Paddy625/LapTune_STM32/docs/P0_REVIEW_2026-11-02.md

# Przegląd P0 — 2 listopada 2026, firmware 2.0.1-p0

> Raport historyczny dla 2.0.1-p0. Aktualne zachowanie GPS/PPS i pamięci opisuje [GPS_PPS.md](GPS_PPS.md).

## Utrata początku: co ustalono

W wersji 4f07d42 `SDLogger_CanAccept()` zwracało true także poza nagrywaniem.
Konsument pobierał wtedy rekord z pierścienia, a `SDLogger_AppendRaw()` odrzucało
go i zwiększało sd_queue_dropped. Dotyczyło to błędów/retry SD, a także B1.
IMU było ponadto uzbrajane przed początkowym montowaniem i przygotowaniem pliku.

Zestaw `imu_ring_dropped=1`, `sd_queue_dropped=3749`, pierwszy NR=3751 jest
zgodny z tą ścieżką: jedna celowo odrzucona para startowa i 3749 rekordów
odrzuconych przez logger. Sama blokada konsumenta przez 37 s przepełniłaby
pierścień wielokrotnie i zwiększyła licznik IMU. Zatem nie jest to dowód, że
pierścień był za mały albo że urządzenie czekało na fix. Kod nie miał bramki
fix/UTC. Stare liczniki nie rozstrzygają, czy początkową przyczyną był błąd
karty, pauza B1 czy inne przejście stanu; brakuje starej historii zdarzeń.

Poprawiony start: zegar i peryferia → odbiór GPS → SD i zsynchronizowany
nagłówek → dopiero inicjalizacja/uzbrojenie IMU. Jeżeli SD nie jest gotowe,
IMU nie zaczyna właściwej akwizycji; nie ma licznika pobranych próbek do
wyzerowania. Konsument działa od pierwszej pary, niezależnie od GPS i UTC.
NR i czas nie są resetowane przy odzyskiwaniu karty ani przejściu do pliku.

Pierwsza para po uzbrojeniu pozostaje celowo odrzucana jako niepewna czasowo;
widać NR=1 i reason=1 w diagnostyce, a pierwszy prawidłowy wiersz zwykle ma
NR=2. To oddzielne zdarzenie od dawnej utraty kilkudziesięciu sekund.

Nowe znaczniki w SESSION.json, w tej samej skali mikrosekund MCU:

| Pole | Znaczenie |
| --- | --- |
| sd_ready_us | pierwsze przygotowanie pliku i udana synchronizacja nagłówka |
| imu_start_us | pierwsze udane uzbrojenie DRDY/DMA; nie resetuje się przy retry |
| first_written_us | chwila powrotu pierwszego udanego f_write z rekordami |
| first_written_sample_us | T_IMU_US pierwszego przyjętego rekordu |
| first_written_nr | oryginalny numer tego rekordu |
| last_drop_nr / last_drop_us / last_drop_reason | ostatnie rzeczywiste odrzucenie, ze wskazaniem etapu |
| sd_mount_attempts / sd_failures | historia prób i niepowodzeń w bieżącym uruchomieniu |
| sd_first_error_us/code, sd_last_error_us/code | pierwszy i ostatni błąd FatFs, bez wymazywania przy retry |

Reason: 0=brak, 1=para po uzbrojeniu, 2=pełny pierścień, 3=utracony oczekujący
DRDY, 5=jawna pauza B1, 7=niepewna paczka przy błędzie f_write. Pełna kolejka SD
lub chwilowa niedostępność karty nie są same w sobie powodem odrzucenia.

## Przepływ i pamięć

Producent IRQ/DMA jest niezależny od FatFs. Konsument najpierw podgląda rekord,
a zwalnia miejsce dopiero po przyjęciu go przez logger. Pełne 16 miejsc SD
wstrzymuje konsumenta; pozostałe próbki czekają w pierścieniu. Po błędzie SD
niepróbowane rekordy SD pozostają w RAM do wznowienia. Nie odtwarzamy starych
obiektów FIL ani sektorów/FAT na nowej karcie. Błąd częściowego zapisu powoduje
jawne odrzucenie tylko próbowanej, niepewnej paczki; importer powinien też
obsługiwać duplikaty po awarii nośnika według sesji i NR.

Pojemności podawane są w **pojedynczych rekordach**, nie w paczkach:

| Bufor | Pojemność | Rozmiar elementu na ARM | RAM |
| --- | ---: | ---: | ---: |
| Pierścień IMU | 256 slotów, 255 użytecznych | 32 B | 8192 B |
| Kolejka SD | 16 rekordów | 96 B | 1536 B |
| Tekstowa paczka zapisu | 1024 bajty | — | 1024 B |
| RX UART | 1024 sloty, 1023 użyteczne | 1 B | 1024 B |
| DMA SPI2 | TX 17 + RX 17 bajtów | — | 34 B |
| TX konfiguracji GPS | 28 bajtów | — | 28 B |

Nie zwiększono liczby slotów. Rekord SD zawiera oryginalny IMU, pomocniczy UTC
i migawkę GPS z czasem odbioru. Pierścień pokrywa około 2,45 s przy nominalnych
104 Hz; kolejka SD około 154 ms. Pauza 1,163 s wymaga około 121 miejsc
w pierścieniu, a nie w kolejce tekstowej. Aktualne i maksymalne zapełnienia są
mierzone: raw_ring_high_water, sd_queue_high_water i sd_queue_depth.

Kompilacja Debug po zmianach: **17 032 B statycznego RAM**, 3448 B na stos/heap.
Linker rezerwuje 2560 B stosu oraz minimum 512 B heap; pozostaje 376 B ponad te
rezerwacje. Heap może zająć łącznie 888 B przy zachowaniu rezerwacji stosu.
To nie jest dodatkowe 20 KB poza buforami. Dokładny raport dla każdej kompilacji
powstaje jako memory-report.json; Release może mieć inne wyrównanie sekcji.

Największe pojedyncze ramki GCC Debug to Session_Write 800 B i formatter 712 B.
To nie jest suma zagnieżdżonych wywołań ani dowód maksymalnego stosu: raporty
.su nie obejmują pełnego wnętrza newlib. Na urządzeniu stos jest znakowany przy
starcie przed HAL i mierzony konserwatywnie; SESSION zawiera stack_reserved_bytes,
stack_free_min_bytes i heap_used_bytes. Należy sprawdzić minimum podczas
rzeczywistego najgorszego zapisu/rysowania/przerwań; w chmurze nie zmierzono
sprzętowego maksimum stosu. Native testy zwracają w tych polach 0.

TX/RX DMA są statyczne i nie kończą życia z funkcją. TX GPS także jest
statyczne, pozostaje zajęte do callbacku TX complete, ma watchdog 100 ms i nie
jest nadpisywane podczas transmisji. Akwizycja nie korzysta z buforów na stosie.

## Zegar i PPS na PA0

Konfiguracja nominalna: HSI/2 × PLL16 = 64 MHz; APB1 /2 = 32 MHz; ponieważ APB
jest dzielone, TIM2 dostaje **2 × PCLK1 = 64 MHz**. PSC=63 daje nominalnie 1 MHz,
ARR=65535 przepełnia się co 65,536 ms. Dla APB /1 mnożnik jest 1, również dla
aliasowych kodów /1. Metadane zapisują wejście, PSC, tick i ARR.

Odczyt 64-bitowy blokuje przerwania na krótki odczyt, uwzględnia UIF przed ISR
i ponownie czyta CNT po zauważeniu przepełnienia. Ta sama funkcja służy IMU,
końcom ramek UART, błędom, zapisowi i migawkom. Nie przeliczamy skali przez
założenie, że IMU ma idealne 104 Hz. Wynik około 103,51 Hz może pochodzić
z zegara MCU, rzeczywistego ODR albo obu i wymaga niezależnej referencji.

**Podłączone PPS → PA0 / A0 / CN8 pin 1**, logika 3,3 V i wspólna masa.
TIM2_CH1 sprzętowo przechwytuje zbocze. ISR rozszerza CCR1 do tej samej skali
64-bitowej, rozróżniając zbocze przed/po przepełnieniu. Zapisywane są:
pps_pulses, pps_last_capture_us, ostatni/min/max/średni okres w taktach TIM2,
pps_periods, pps_capture_overruns i pps_rejected_periods. Okresy poza
0,8–1,2 s nominalnego czasu MCU nie są używane do średniej 1 Hz.

Do rzeczywistego pomiaru trzeba potwierdzić, że PPS odbiornika to ważna,
GNSS-zablokowana referencja 1 Hz. Wtedy średnia liczba taktów na impuls
pokazuje skalę zegara: przy nominalnych 1 MHz różnica od 1 000 000 taktów ma
tę samą wartość liczbową w ppm. Nie dyscyplinujemy ani nie przestawiamy licznika.
W tej sesji nie otrzymano nowych pomiarów z płytki, dlatego pozostaje
**timestamp_accuracy_validated=false** i pps_reference_validated=false.

```sh
python3 tools/check_session.py /sciezka/do/folderu/sesji
```

Narzędzie sprawdza monotoniczność, luki NR, rozkład dt, stan zapisu i diagnostykę
PPS. Nie zamienia zadanej ODR w referencję czasu.

## UART GPS i epoki

Poprzednie 13 zbiorczych błędów nie pozwala ustalić ich rodzaju ani momentu.
Ich późniejsza stała wartość jest zgodna z błędami podczas baudrate/startu,
ale nie dowodzi tego. Nowa diagnostyka rozdziela framing, noise, overrun,
parity i other oraz fazy init/reconfigure i run. Run oznacza stan konfiguracji
READY, a nie obecność fixa. Są czasy pierwszego/ostatniego błędu UART globalnie
i w każdej fazie, oddzielne checksum init/run oraz ich pierwsze/ostatnie czasy.
Kilka ustawionych bitów w jednym callbacku zwiększa odpowiednie liczniki,
lecz globalny uart_errors rośnie raz. Historii nie kasuje ponowne wykrycie GPS.

Konfiguracja używa teraz HAL_UART_Transmit_IT, bez blokującego oczekiwania
80 ms. Czekanie na odpowiedzi odbywa się stanami/deadline'ami, obok zapisu IMU.
Pole gps_configuration_state: **0=pending/configuring, 1=READY po ACK i readback,
2=ERROR**. Wartość 1 nie potwierdza fixa, UTC, PPS ani dokładności czasu.

CSV ma **36 kolumn**. Dotychczasowe 33 pozostają na początku; dochodzą
GPS_T_RX_US, GPS_T_MEAS_US i TIME_SYNC_STATE. Przy I współrzędne, prędkość
i wysokość nadal są puste, ale znane ID/iTOW/RX pozostają liczbami, także
z ostatniej znanej epoki podczas timeoutu. I ma pierwszeństwo; obecność ID
nie czyni pozycji ważną. Przed odebraniem jakiejkolwiek epoki pola są puste.

- gps_received_epochs: jedna nowa zidentyfikowana epoka NAV według iTOW, od pierwszego poprawnego checksum fragmentu.
- gps_published_epochs: epoki opublikowane po skompletowaniu/deadline; starsze od już opublikowanej mogą zostać odrzucone.
- gps_valid_epochs: opublikowane epoki z poprawną pozycją.
- GPS_INVALID_FIXES / gps_invalid_fixes: nowe opublikowane nieważne epoki; nie kolejne pętle, timeouty ani powtarzane wiersze I.

POSLLH, VELNED i SOL nadal są łączone tylko po identycznym iTOW. Cache R jest
niezmienne. Identyczna nowa pozycja otrzymuje N i nowy ID. Późna wysokość lub
prędkość nie poprawia już opublikowanej epoki. ID jest monotoniczne w sesji,
a iTOW jest oryginalnym czasem tygodnia i może prawidłowo wynosić 0.

## Migawki i synchronizacja zapisu

snapshot_t_us określa chwilę przejęcia kopii liczników, a nie zakończenia
zapisu JSON. Kopie IMU/UART są przejmowane atomowo względem ISR; FatFs może
potem obsługiwać nowe ramki bez zmiany tej migawki. SESSION.bak jest poprzednią
migawką tego samego boot_id. Aktualizacja: start, zmiana konfiguracji,
co około 5 s, rotacja i kontrolowane B1. Wiersze są synchronizowane przed
okresową migawką; zamknięcie pliku potwierdza punkt końca przy rotacji/B1.

sd_written to liczba rekordów przyjętych przez **f_write**. sd_synced_records
liczy rekordy objęte udanym **f_sync/f_close**. Są też last_acquired_nr,
last_written_nr, last_synced_nr, last_synced_sample_us i last_synced_us.
Synchronizacja nowego, pustego nagłówka nie potwierdza rekordów starego pliku.
last_synced_nr nie oznacza, że każda niższa NR przeżyła awarie nośnika;
sd_synced_records i luki pozwalają odróżnić te sytuacje.
clean_shutdown=true oznacza kontrolowane zamknięcie loggera, nie wyłączenie
MCU ani zatrzymanie samego czujnika. Otwarcie/retry ustawia false.

Nagły zanik zasilania nie wykona końcowego JSON. Metadane mogą być o około
5 s starsze od TXT, a awaria FAT może poszerzyć różnicę; rotacja nie jest
transakcją. Backup nie daje gwarancji zachowania wszystkich danych bez
podtrzymania zasilania. Nie ogłaszamy f_write jako potwierdzenia trwałości flash.

SHA jest generowane automatycznie zarówno przez tools/build_firmware.py,
jak i prebuild CubeIDE Debug/Release. Wymagane są Git i Python w PATH.
firmware_commit ma 40 znaków SHA, firmware_dirty osobno sygnalizuje zmiany.
Brak Git/SHA zatrzymuje build zamiast wpisywać unspecified. W CubeIDE należy
wykonać Clean/Build po odświeżeniu .cproject.

## P1: granica wykonanej pracy

GPS_T_RX_US jest rzeczywistym czasem ostatniego potrzebnego odebranego
fragmentu UBX. Deadline nie jest podstawiany jako RX. GPS_T_MEAS_US pozostaje
puste, TIME_SYNC_STATE=0. Samo przechwytywanie PPS nie rozstrzyga, do którego
impulsu/tygodnia/iTOW należy konkretne rozwiązanie. Nie zgadujemy tego
z najbliższej wiadomości UART.

Następny krok to potwierdzenie zachowania TIMEPULSE/TIM-TP na firmware
z MON-VER, powiązanie właściwego impulsu z czasem GPS i estymacja mapowania
zegarów oraz błędu. Potem można przypisywać GPS do historycznych prawdziwych
wierszy albo wprowadzić opóźnione korekty w Windows. Obecny ESKF nie zacznie
tego robić po dodaniu samych kolumn. Nie deklarujemy GPS–IMU ≤5 ms.

## Weryfikacja

15 programów C z ASan/UBSan i niezależny konsument CSV/JSON przechodzą.
Test całego toru używa rzeczywistego kodu ISR/DMA, konsumenta i FatFs: brak
SD przez 37 s przed uzbrojeniem, brak GPS/UTC, pełna kolejka 16, pauza
1,163415 s z 121 zdarzeniami i brak strat poza oznaczoną parą startową.
Następnie wymuszony nadmiar daje pełny pierścień, luki NR i reason=2.
To test symulowany, nie pomiar zachowania konkretnej karty.

Pozostałe regresje: dwie godziny zegara i przepełnienia/wyścig odczytu,
capture przed/po overflow, syntetyczne PPS ze skalą +4700 ppm, 13 startowych
błędów UART zachowanych po rekonfiguracji, runtime FE/NE/ORE, deadline i
ważność epok, 30 minut czasu symulowanego FatFs, TXT2 i okresowe/końcowe
migawki z punktami sync oraz clean_shutdown. Testy nie mierzą fizycznego
p99 timestampu, dryfu HSI, skali PPS ani maksimum stosu na Nucleo.
