Paddy625/LapTune_STM32/docs/wiring_sd.png

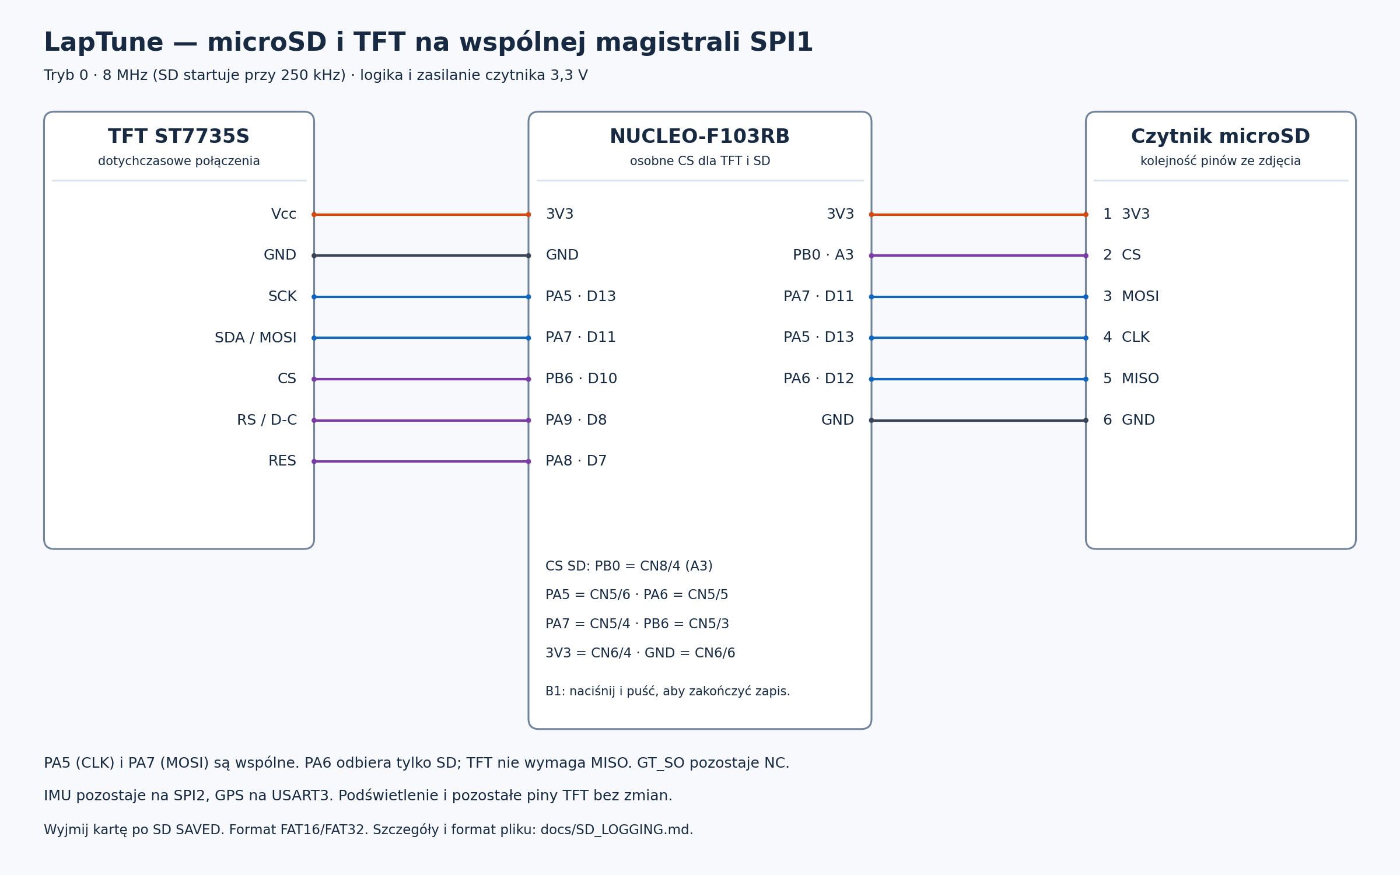
docs/wiring_sd.png
