Paddy625/LapTune_STM32/LapTune/Core/Src/main.c

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
/* Includes ------------------------------------------------------------------*/
#include "main.h"

/* USER CODE BEGIN Includes */

#include "acc.h"
#include "boot_identity.h"
#include "timebase.h"
#include "memory_diag.h"
#include "imu_stream.h"
#include "acc_display.h"
#include "gps.h"
#include "gps_display.h"
#include "sd_spi.h"
#include "sd_logger.h"
#include <stdio.h>
#include <string.h>

/* USER CODE END Includes */

SPI_HandleTypeDef hspi1;
SPI_HandleTypeDef hspi2;

UART_HandleTypeDef huart2;
UART_HandleTypeDef huart3;

/* USER CODE BEGIN PV */

float ax, max_x=0, min_x=0, ay, max_y=0, min_y=0, az, max_z=0, min_z=0;
float gx, min_gx=0, max_gx=0, gy, min_gy=0, max_gy=0, gz, min_gz=0, max_gz=0;
static uint8_t sensor_ok, have_sample, sample_valid;
static uint32_t last_sensor_retry;
static uint8_t app_ready,tft_ready;
static uint32_t last_ui_slice;
static uint32_t last_ui_nr;

/* USER CODE END PV */

void SystemClock_Config(void);
static void MX_GPIO_Init(void);
static void MX_USART2_UART_Init(void);
static void MX_USART3_UART_Init(void);
static void MX_SPI1_Init(void);
static void MX_SPI2_Init(void);
/* USER CODE BEGIN PFP */
void Logger_OnImuRecord(const ImuRecord *record);

/* USER CODE END PFP */

/* USER CODE BEGIN 0 */
void Logger_ServiceIO(void)
{
  if (!app_ready) return;
  GPS_Process((uint32_t)(Timebase_NowUs()/1000U));
  ImuStream_Service();
}
static void ServiceAcquisition(void)
{
  if (!app_ready) return;
  GPS_Process((uint32_t)(Timebase_NowUs()/1000U));
  ImuStream_Service();
  ImuRecord latest;
  if (ImuStream_Latest(&latest) && latest.nr!=last_ui_nr) Logger_OnImuRecord(&latest);
  SDLogger_ConsumeImu();
}
void Logger_OnImuRecord(const ImuRecord *record)
{
    if (record->flags) {
      if (record->nr>=last_ui_nr) { last_ui_nr=record->nr; sample_valid=0; }
      return;
    }
    LSM6DS3_Sample sample;
    ImuStream_Scale(record,&sample);
    /* Old buffered samples update extrema without moving the live values backwards. */
    if (!have_sample) {
      min_x=max_x=sample.ax; min_y=max_y=sample.ay; min_z=max_z=sample.az;
      min_gx=max_gx=sample.gx; min_gy=max_gy=sample.gy; min_gz=max_gz=sample.gz;
      have_sample=1;
    }
    if (sample.ax>max_x) max_x=sample.ax;
    if (sample.ax<min_x) min_x=sample.ax;
    if (sample.ay>max_y) max_y=sample.ay;
    if (sample.ay<min_y) min_y=sample.ay;
    if (sample.az>max_z) max_z=sample.az;
    if (sample.az<min_z) min_z=sample.az;
    if (sample.gx>max_gx) max_gx=sample.gx;
    if (sample.gx<min_gx) min_gx=sample.gx;
    if (sample.gy>max_gy) max_gy=sample.gy;
    if (sample.gy<min_gy) min_gy=sample.gy;
    if (sample.gz>max_gz) max_gz=sample.gz;
    if (sample.gz<min_gz) min_gz=sample.gz;
    if (record->nr>=last_ui_nr) {
      last_ui_nr=record->nr; sample_valid=1;
      ax=sample.ax; ay=sample.ay; az=sample.az;
      gx=sample.gx; gy=sample.gy; gz=sample.gz;
    }

}

/* Storage may call this while a FatFs write is in progress. IMU acquisition
   continues in EXTI/DMA; only drain GPS here, never re-enter the SD queue. */
void SD_SPI_Service(void)
{
  if (!app_ready) return;
  GPS_Process((uint32_t)(Timebase_NowUs()/1000U));
}

static HAL_StatusTypeDef ShowLogState(void)
{
  static char previous[26];
  char text[26];
  SDLogger_StatusText(text);
  if (!strcmp(previous,text)) return HAL_OK;
  HAL_StatusTypeDef result=TFT_Text(4,120,text,1,sd_log_state==LOG_RECORDING || sd_log_state==LOG_STOPPED ? TFT_WHITE : TFT_RED,TFT_BLACK);
  if (result==HAL_OK) (void)strcpy(previous,text);
  return result;
}


/* USER CODE END 0 */

/**
  * @brief  The application entry point.
  * @retval int
  */
int main(void)
{

  /* USER CODE BEGIN 1 */
  MemoryDiag_Init();

  /* USER CODE END 1 */

  /* MCU Configuration--------------------------------------------------------*/

  /* Reset of all peripherals, Initializes the Flash interface and the Systick. */
  HAL_Init();

  /* Configure the system clock */
  SystemClock_Config();

  /* USER CODE BEGIN SysInit */
  /* Flash journal is updated before the acquisition clock/interrupts start. */
  if (!BootIdentity_Init()) Error_Handler();
  Timebase_Init();

  /* USER CODE END SysInit */

  /* Initialize all configured peripherals */
  MX_GPIO_Init();
  MX_USART2_UART_Init();
  MX_SPI2_Init();
  MX_SPI1_Init();
  MX_USART3_UART_Init();
  /* USER CODE BEGIN 2 */

  tft_ready=TFT_Init(&hspi1)==HAL_OK && AccDisplay_Init()==HAL_OK;
  if (GPS_Init(&huart3) != HAL_OK) Error_Handler();
  /* GPS configures 5 Hz and PPS asynchronously, independent of fix and SD. */
  app_ready=1; /* GPS RX/configuration can be serviced during initial SD setup. */
  SD_SPI_Bind(&hspi1);
  SDLogger_Start(); /* Prepare and sync the file before arming acquisition. */
  last_sensor_retry=HAL_GetTick()-1000U;

  /* USER CODE END 2 */

  /* Infinite loop */
  /* USER CODE BEGIN WHILE */
  while (1)
  {
    /* USER CODE END WHILE */

    /* USER CODE BEGIN 3 */
    ServiceAcquisition();
    uint32_t now=HAL_GetTick();
    if (sensor_ok && (uint32_t)(now-last_sensor_retry)>=1000U &&
        ImuStream_Stalled(1000000U)) {
      ImuStream_Stop(); sensor_ok=0;
    }
    if (!sensor_ok && (uint32_t)(now-last_sensor_retry)>=1000U) {
      ImuStream_Stop();
      sensor_ok=Logger_StartAcquisition();
      last_sensor_retry=HAL_GetTick();
    }
    Logger_ServiceStorage();
    if (!tft_ready || SDLogger_Backlogged() || (uint32_t)(HAL_GetTick()-last_ui_slice)<100U) {
      HAL_Delay(1U);
      continue;
    }
    last_ui_slice=HAL_GetTick();
    const IMU_DisplayData readings = {
      .accel = {ax, ay, az},
      .accel_min = {min_x, min_y, min_z},
      .accel_max = {max_x, max_y, max_z},
      .gyro = {gx, gy, gz},
      .gyro_min = {min_gx, min_gy, min_gz},
      .gyro_max = {max_gx, max_gy, max_gz}
    };
    if (AccDisplay_Update(HAL_GetTick(), &readings,
                          sensor_ok && have_sample && sample_valid) != HAL_OK) {
      tft_ready=0;
    }
    if (tft_ready && GPSDisplay_Update(HAL_GetTick(), GPS_GetData(), GPS_GetConfig()) != HAL_OK) {
      tft_ready=0;
    }
    if (tft_ready && ShowLogState()!=HAL_OK) tft_ready=0;
    HAL_Delay(1U);
  }
  /* USER CODE END 3 */
}

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
/* USER CODE BEGIN 4 */
void HAL_GPIO_EXTI_Callback(uint16_t pin)
{
  /* Debounced B1 release requests foreground stop/resume; no FatFs in IRQ. */
  if (pin==GPIO_PIN_1) ImuStream_OnDrdy(0);
  else if (pin==GPIO_PIN_4) ImuStream_OnDrdy(1);
  else if (pin==B1_Pin) SDLogger_Button();
}

void HAL_SPI_TxRxCpltCallback(SPI_HandleTypeDef *spi)
{ if (spi==&hspi2) ImuStream_OnComplete(); }
void HAL_SPI_ErrorCallback(SPI_HandleTypeDef *spi)
{ if (spi==&hspi2) ImuStream_OnError(); }

void HAL_UART_RxCpltCallback(UART_HandleTypeDef *uart)
{
  GPS_OnRxComplete(uart);
}

void HAL_UART_TxCpltCallback(UART_HandleTypeDef *uart)
{ GPS_OnTxComplete(uart); }

void HAL_UART_ErrorCallback(UART_HandleTypeDef *uart)
{
  GPS_OnError(uart);
}


/* USER CODE END 4 */
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
