Paddy625/LapTune_STM32/LapTune/Core/Inc/main.h

#define B1_Pin GPIO_PIN_13
#define B1_GPIO_Port GPIOC
#define B1_EXTI_IRQn EXTI15_10_IRQn
#define USART_TX_Pin GPIO_PIN_2
#define USART_TX_GPIO_Port GPIOA
#define USART_RX_Pin GPIO_PIN_3
#define USART_RX_GPIO_Port GPIOA
#define TFT_CS_Pin GPIO_PIN_6
#define TFT_CS_GPIO_Port GPIOB
#define TFT_DC_Pin GPIO_PIN_9
#define TFT_DC_GPIO_Port GPIOA
#define TFT_RST_Pin GPIO_PIN_8
#define TFT_RST_GPIO_Port GPIOA
#define TMS_Pin GPIO_PIN_13
#define TMS_GPIO_Port GPIOA
#define TCK_Pin GPIO_PIN_14
#define TCK_GPIO_Port GPIOA
#define SWO_Pin GPIO_PIN_3
#define SWO_GPIO_Port GPIOB
#define SD_CS_Pin GPIO_PIN_0
#define SD_CS_GPIO_Port GPIOB
