Paddy625/LapTune_STM32/LapTune/Core/Src/gps_epoch.c

#include "gps_epoch.h"
#include "gps_time.h"
#include <string.h>
#define WEEK_MS 604800000UL
#define HISTORY 16U
_Static_assert(sizeof(GPS_Fix)==48,"GPS snapshot RAM budget");
typedef struct {
    uint64_t first_us,last_us;
    GPS_Fix fix;
    int16_t week;
    uint8_t seen,parts,fix_type,flags,satellites;
} Slot;
static Slot slots[4];
static GPS_Fix history[HISTORY];
static unsigned history_head,history_count;
static uint32_t sequence,last_itow;
static uint64_t last_valid_rx,stream_start_us;
static int16_t last_week;
static uint8_t have_itow;
GPS_Diagnostics gps_diag;
static uint8_t nmea_mode,nmea_parts,nmea_valid,have_nmea_key;
static uint32_t nmea_key,last_nmea_key;
static uint64_t nmea_first,last_nmea_rx;
static GPS_Fix nmea_pending;
static void nmea_publish(uint64_t now)
{
    if (!nmea_parts) return;
    nmea_pending.position_valid=nmea_valid==nmea_parts;
    nmea_pending.altitude_valid&=nmea_pending.position_valid;
    nmea_pending.speed_valid&=nmea_pending.position_valid;
    nmea_pending.published_us=now;
    nmea_pending.fix_id=++sequence; nmea_pending.epoch_known=1; nmea_pending.nmea=1;
    nmea_pending.meas_delay_us=UINT32_MAX;
    ++gps_diag.received_epochs; ++gps_diag.epoch_count;
    if (nmea_pending.position_valid) ++gps_diag.valid_epochs; else ++gps_diag.invalid_fixes;
    if (have_nmea_key) {
        uint32_t dt=(nmea_key+86400000U-last_nmea_key)%86400000U;
        if (dt && dt<=3000) {
            if (!gps_diag.min_period_ms || dt<gps_diag.min_period_ms) gps_diag.min_period_ms=dt;
            if (dt>gps_diag.max_period_ms) gps_diag.max_period_ms=dt;
            if (dt!=1000) ++gps_diag.bad_period;
        }
    }
    last_nmea_key=nmea_key; last_nmea_rx=nmea_pending.rx_us; have_nmea_key=1;
    history[history_head]=nmea_pending; history_head=(history_head+1U)%HISTORY;
    if (history_count<HISTORY) ++history_count;
    nmea_parts=nmea_valid=0;
}
static uint8_t nmea_time(const char *line,uint32_t *key)
{
    const char *p=strchr(line,','); if (!p || strlen(++p)<6) return 0;
    unsigned h=0,m=0,sec=0,ms=0;
    for (unsigned i=0;i<6;++i) if (p[i]<'0' || p[i]>'9') return 0;
    h=(p[0]-'0')*10U+p[1]-'0'; m=(p[2]-'0')*10U+p[3]-'0'; sec=(p[4]-'0')*10U+p[5]-'0';
    if (h>23 || m>59 || sec>59) return 0;
    p+=6;
    if (*p=='.') {
        unsigned scale=100; ++p;
        if (*p<'0' || *p>'9') return 0;
        while (*p>='0' && *p<='9') { ms+=(*p++-'0')*scale; scale/=10; }
    }
    if (*p!=',') return 0;
    *key=((h*60U+m)*60U+sec)*1000U+ms; return 1;
}
static uint32_t u32(const uint8_t *p) { return (uint32_t)p[0]|((uint32_t)p[1]<<8)|((uint32_t)p[2]<<16)|((uint32_t)p[3]<<24); }
static int32_t i32(const uint8_t *p) { uint32_t n=u32(p); return n<=INT32_MAX ? (int32_t)n : (int32_t)((int64_t)n-4294967296LL); }
static void remember(GPS_Fix fix)
{
    history[history_head]=fix; history_head=(history_head+1U)%HISTORY;
    if (history_count<HISTORY) ++history_count;
}
static void invalidate(GPS_Data *d,uint64_t now)
{
    if (d->position_valid || !history_count || history[(history_head+HISTORY-1)%HISTORY].position_valid)
    {
        GPS_Fix f=history_count ? history[(history_head+HISTORY-1)%HISTORY] : (GPS_Fix){0};
        f.published_us=now; f.position_valid=f.speed_valid=f.altitude_valid=0;
        f.time_sync_state=f.discarded_incomplete=0; f.meas_delay_us=UINT32_MAX;
        remember(f);
    }
    d->position_valid=d->speed_valid=d->altitude_valid=0;
}
void GPS_Epoch_Init(void)
{
    nmea_mode=nmea_parts=nmea_valid=have_nmea_key=0;
    memset(slots,0,sizeof(slots)); memset(history,0,sizeof(history)); memset(&gps_diag,0,sizeof(gps_diag));
    history_head=history_count=sequence=last_itow=have_itow=0; last_valid_rx=stream_start_us=0; last_week=0;
    GPS_Time_Init();
}
void GPS_Epoch_InitNMEA(void) { GPS_Epoch_Init(); nmea_mode=1; }
void GPS_Epoch_NMEA(const GPS_Data *d,const char *line,uint64_t rx)
{
    uint32_t key;
    if (!nmea_time(line,&key)) {
        nmea_parts=nmea_valid=0;
        GPS_Fix invalid={.published_us=rx,.rx_us=rx,.meas_delay_us=UINT32_MAX,.nmea=1};
        remember(invalid); return;
    }
    uint8_t part=line[3]=='G' ? 1 : 2;
    if (have_nmea_key && key==last_nmea_key && rx>=last_nmea_rx && rx-last_nmea_rx<3000000U) return;
    if (nmea_parts && key!=nmea_key) nmea_publish(rx);
    if (!nmea_parts) {
        nmea_pending=(GPS_Fix){0}; nmea_first=rx; nmea_key=key; nmea_valid=0;
    }
    if (nmea_parts&part) return;
    nmea_parts|=part; nmea_pending.rx_us=rx;
    if (d->position_valid) {
        nmea_valid|=part;
        /* Prefer RMC coordinates when both members of this UTC epoch exist. */
        if (part==2 || !(nmea_parts&2)) {
            nmea_pending.latitude_e7=d->latitude_e7; nmea_pending.longitude_e7=d->longitude_e7;
        }
    }
    if (part==1) { nmea_pending.altitude_valid=d->altitude_valid; nmea_pending.altitude_mm=d->altitude_mm; }
    else { nmea_pending.speed_valid=d->speed_valid; nmea_pending.speed_millikmh=d->speed_millikmh; }
    if (nmea_parts==3) nmea_publish(rx);
}
void GPS_Epoch_ResetStream(GPS_Data *d,uint64_t now)
{
    nmea_parts=nmea_valid=have_nmea_key=0;
    invalidate(d,now); memset(slots,0,sizeof(slots)); have_itow=0; stream_start_us=now;
    d->connected=d->datetime_valid=d->receiver_fix_valid=0;
    GPS_Time_Reset();
}
static void publish(GPS_Data *d,Slot *s,uint64_t now)
{
    GPS_Fix *f=&s->fix;
    f->published_us=now; f->rx_us=s->last_us; f->epoch_known=1;
    f->time_valid=(s->parts&4U) && (s->flags&0x0CU)==0x0CU && s->week>=0;
    f->position_valid=(s->parts&5U)==5U && f->time_valid && (s->flags&1U) && (s->fix_type==2 || s->fix_type==3);
    f->speed_valid=f->position_valid && (s->parts&2U);
    f->altitude_valid=f->position_valid && s->fix_type==3;
    f->meas_delay_us=UINT32_MAX; f->time_sync_state=0;
    if (f->position_valid) {
        /* An unqualified pre-fix TOW must never become the ordering anchor.
           After a real fix outage, accept the receiver's corrected time afresh. */
        if (have_itow) {
            int64_t dt=(int64_t)(s->week-last_week)*WEEK_MS+(int64_t)f->itow_ms-last_itow;
            if (dt<=0 && f->rx_us>=last_valid_rx && f->rx_us-last_valid_rx<GPS_EPOCH_TIMEOUT_US) {
                ++gps_diag.late; s->seen=s->parts=0; return;
            }
            if (dt>0 && dt<=1000) {
                if (!gps_diag.min_period_ms || (uint32_t)dt<gps_diag.min_period_ms) gps_diag.min_period_ms=(uint32_t)dt;
                if ((uint32_t)dt>gps_diag.max_period_ms) gps_diag.max_period_ms=(uint32_t)dt;
                if (dt!=200) ++gps_diag.bad_period;
            }
        }
        last_itow=f->itow_ms; last_week=s->week; last_valid_rx=f->rx_us; have_itow=1;
    }
    if (f->time_valid) {
        GPS_Time_Navigation((uint16_t)s->week,f->itow_ms,f->rx_us);
        uint64_t measurement;
        if (GPS_Time_Map((uint16_t)s->week,f->itow_ms,f->rx_us,&measurement)) {
            f->meas_delay_us=(uint32_t)(f->rx_us-measurement); f->time_sync_state=1;
        }
    }
    ++gps_diag.epoch_count;
    if (!f->position_valid) ++gps_diag.invalid_fixes; else ++gps_diag.valid_epochs;
    /* A missing status fragment is not evidence that the receiver lost its fix.
       Keep the last complete solution only until its explicit 800 ms expiry. */
    uint8_t incomplete_status=(s->parts&5U)!=5U;
    if (!f->position_valid && incomplete_status && d->position_valid &&
        now>=last_valid_rx && now-last_valid_rx<GPS_EPOCH_TIMEOUT_US) {
        /* Keep a tombstone for duplicate rejection without replacing the live cache. */
        f->discarded_incomplete=1; remember(*f);
        s->seen=s->parts=0; return;
    }
    remember(*f);
    d->position_valid=f->position_valid; d->speed_valid=f->speed_valid; d->altitude_valid=f->altitude_valid;
    d->latitude_e7=f->latitude_e7; d->longitude_e7=f->longitude_e7;
    d->altitude_mm=f->altitude_mm; d->speed_millikmh=f->speed_millikmh;
    d->position_ms=d->speed_ms=d->altitude_ms=(uint32_t)(now/1000U);
    d->fix_quality=d->position_valid ? ((s->flags&2U)?2:1) : 0;
    s->seen=s->parts=0;
}
static uint8_t days(uint16_t y,uint8_t m)
{
    static const uint8_t table[]={31,28,31,30,31,30,31,31,30,31,30,31};
    return table[m-1]+(m==2 && y%4==0 && (y%100!=0 || y%400==0));
}
static void utc_rejected(const uint8_t *p,unsigned len,uint64_t now,uint8_t reason)
{
    GPS_UTCDiagnostics *u=&gps_diag.utc;
    u->last_rejected_us=now; u->last_rejected_reason=reason;
    u->last_rejected_length=(uint16_t)len;
    memset(u->last_rejected_payload,0,sizeof(u->last_rejected_payload));
    unsigned stored=len<sizeof(u->last_rejected_payload) ? len : sizeof(u->last_rejected_payload);
    if (stored) memcpy(u->last_rejected_payload,p,stored);
}
static void utc(GPS_Data *d,const uint8_t *p,unsigned len,uint64_t now)
{
    GPS_UTCDiagnostics *u=&gps_diag.utc;
    if (!u->packets) u->first_rx_us=now;
    ++u->packets; u->last_rx_us=now;
    if (len!=20) {
        ++u->rejected_length; utc_rejected(p,len,now,GPS_UTC_REJECT_LENGTH);
        return; /* Preserve the existing behavior: malformed lengths do not update UTC. */
    }
    ++u->flags_histogram[p[19]&7U];
    gps_diag.receiver.utc_flags=p[19]; gps_diag.receiver.seen|=GPS_RX_UTC;
    uint16_t year=(uint16_t)p[12]|((uint16_t)p[13]<<8);
    if ((p[19]&7)!=7) {
        ++u->rejected_flags; utc_rejected(p,len,now,GPS_UTC_REJECT_FLAGS);
        d->datetime_valid=0; return;
    }
    if (year<1980 || year>2099 || !p[14] || p[14]>12 || !p[15] ||
        p[15]>days(year,p[14]) || p[16]>23 || p[17]>59 || p[18]>59) {
        ++u->rejected_calendar; utc_rejected(p,len,now,GPS_UTC_REJECT_CALENDAR);
        d->datetime_valid=0; return;
    }
    int32_t nano=i32(p+8); if (nano<=-1000000000 || nano>=1000000000) {
        ++u->rejected_nano; utc_rejected(p,len,now,GPS_UTC_REJECT_NANO);
        d->datetime_valid=0; return;
    }
    if (!u->accepted) u->first_valid_us=now;
    ++u->accepted;
    int32_t ms=nano<0 ? -(int32_t)((-(int64_t)nano+999999)/1000000) : nano/1000000;
    int32_t day_ms=((int32_t)p[16]*3600+p[17]*60+p[18])*1000+ms;
    d->year=year; d->month=p[14]; d->day=p[15];
    if (day_ms<0) { day_ms+=86400000; if (--d->day==0) { if (--d->month==0) { d->month=12; --d->year; } d->day=days(d->year,d->month); } }
    if (day_ms>=86400000) { day_ms-=86400000; if (++d->day>days(d->year,d->month)) { d->day=1; if (++d->month>12) { d->month=1; ++d->year; } } }
    d->hour=day_ms/3600000; d->minute=(day_ms/60000)%60; d->second=(day_ms/1000)%60; d->millisecond=day_ms%1000;
    d->datetime_ms=(uint32_t)(now/1000U); d->datetime_valid=1;
    GPS_Time_Utc(u32(p),d,now);
}
void GPS_Epoch_Packet(GPS_Data *d,uint8_t cls,uint8_t id,const uint8_t *p,unsigned len,uint64_t now)
{
    if (cls!=1) return;
    if (id==0x21) {
        utc(d,p,len,now);
        if (len==20) { d->sentence_ms=(uint32_t)(now/1000U); d->connected=1; }
        return;
    }
    uint8_t part=(id==2 && len==28)?1:((id==0x12 && len==36)?2:((id==6 && len==52)?4:0));
    if (!part) return;
    if (part==4) {
        GPS_ReceiverStatus *r=&gps_diag.receiver;
        uint16_t week=(uint16_t)p[8]|((uint16_t)p[9]<<8);
        r->week=week<=INT16_MAX ? (int16_t)week : (int16_t)((int32_t)week-65536);
        r->fix_type=p[10]; r->sol_flags=p[11]; r->used_sats=p[47]; r->seen|=GPS_RX_SOL;
    }
    d->connected=1; d->sentence_ms=(uint32_t)(now/1000U);
    uint32_t itow=u32(p); if (itow>=WEEK_MS) return;
    Slot *s=NULL,*empty=NULL,*oldest=&slots[0];
    for (unsigned i=0;i<4;++i) {
        if (slots[i].seen && slots[i].fix.itow_ms==itow) s=&slots[i];
        if (!slots[i].seen) empty=&slots[i];
        if (slots[i].first_us<oldest->first_us) oldest=&slots[i];
    }
    if (!s) {
        for (unsigned i=0;i<history_count;++i) {
            const GPS_Fix *past=&history[(history_head+HISTORY-1U-i)%HISTORY];
            if (past->epoch_known && past->rx_us>=stream_start_us && past->itow_ms==itow && now>=past->rx_us && now-past->rx_us<2000000U) {
                /* A new qualified SOL may supersede an unqualified startup TOW. */
                if (!(part==4 && !past->time_valid && !past->discarded_incomplete && (p[11]&0x0C)==0x0C)) { ++gps_diag.late; return; }
            }
        }
        s=empty ? empty : oldest;
        if (s->seen) { ++gps_diag.incomplete; publish(d,s,now); }
        memset(s,0,sizeof(*s)); s->first_us=now; s->fix.itow_ms=itow; s->fix.fix_id=++sequence; s->fix.meas_delay_us=UINT32_MAX; ++gps_diag.received_epochs;
    }
    if (s->seen&part) { ++gps_diag.late; return; }
    s->seen|=part; s->last_us=now;
    if (part==1) {
        int32_t lon=i32(p+4),lat=i32(p+8);
        if (lat< -900000000 || lat>900000000 || lon< -1800000000 || lon>1800000000) return;
        s->fix.longitude_e7=lon; s->fix.latitude_e7=lat; s->fix.altitude_mm=i32(p+16);
    } else if (part==2) { if (u32(p+20)>UINT32_MAX/36U) return; s->fix.speed_millikmh=u32(p+20)*36U; }
    else {
        s->fix_type=p[10]; s->flags=p[11]; s->satellites=p[47];
        uint16_t week=(uint16_t)p[8]|((uint16_t)p[9]<<8);
        s->week=week<32768U ? (int16_t)week : -1;
        d->satellites=s->satellites;
        d->receiver_fix_valid=(s->flags&1U) && (s->fix_type==2 || s->fix_type==3);
        if (!d->receiver_fix_valid || (s->flags&0x0CU)!=0x0CU) have_itow=0;
    }
    s->parts|=part; s->last_us=now;
    if (s->parts==7) publish(d,s,now);
}
void GPS_Epoch_Service(GPS_Data *d,uint64_t now)
{
    if (nmea_mode) {
        /* Default 9600 baud also carries GLL/GSA/GSV/VTG. Allow a full cycle
           for the matching RMC/GGA; publish a partial epoch without stale fields. */
        if (nmea_parts && now>=nmea_first && now-nmea_first>=800000U) nmea_publish(now);
        return; /* Live TFT validity remains exactly the legacy NMEA parser's. */
    }
    /* Oldest pending epoch first; a later fragment cannot revise a published fix. */
    for (unsigned n=0;n<4;++n) {
        Slot *old=NULL;
        for (unsigned i=0;i<4;++i) if (slots[i].seen && (!old || slots[i].first_us<old->first_us)) old=&slots[i];
        if (!old || now<old->first_us || now-old->first_us<GPS_ASSEMBLY_DEADLINE_US) break;
        ++gps_diag.incomplete; publish(d,old,old->first_us+GPS_ASSEMBLY_DEADLINE_US);
    }
    if (d->position_valid && now>=last_valid_rx && now-last_valid_rx>=GPS_EPOCH_TIMEOUT_US) invalidate(d,now);
    if ((uint32_t)((uint32_t)(now/1000U)-d->sentence_ms)>=3000U)
        d->connected=d->receiver_fix_valid=d->satellites=0;
    if ((uint32_t)((uint32_t)(now/1000U)-d->datetime_ms)>=3000U) d->datetime_valid=0;
}
void GPS_Epoch_ForWindow(uint64_t sample,uint64_t midpoint,GPS_Fix *out)
{
    memset(out,0,sizeof(*out)); out->meas_delay_us=UINT32_MAX;
    uint64_t best=0; uint8_t found=0;
    for (unsigned i=0;i<history_count;++i) {
        const GPS_Fix *f=&history[(history_head+HISTORY-1U-i)%HISTORY];
        if (f->discarded_incomplete) continue;
        uint64_t at=f->time_sync_state ? f->rx_us-f->meas_delay_us : f->published_us;
        if (at<=midpoint && (!found || at>best)) {
            *out=*f; best=at; found=1;
        }
    }
    if (!found) { if (history_count) ++gps_diag.history_misses; return; }
    if (sample>=best && sample-best>=(out->nmea ? 3000000ULL : GPS_EPOCH_TIMEOUT_US))
        out->position_valid=out->speed_valid=out->altitude_valid=0;
}
void GPS_Epoch_ForSample(uint64_t sample,GPS_Fix *out) { GPS_Epoch_ForWindow(sample,sample,out); }
