Paddy625/LapTune_STM32/tests/test_sd_spi.c

#include "sd_spi.h"
#include "main.h"
#include "diskio.h"
#include <assert.h>
#include <stdio.h>
#include <string.h>
GPIO_TypeDef gpio_a,gpio_b;
static SPI_HandleTypeDef spi;
static uint8_t selected,tft_selected,initialized,legacy,absent,bad_crc,bad_write,forever_busy;
static uint8_t reject_crc_command,command_since_select,hal_timeout,wrong_echo;
static uint8_t replies[1024],pending[512],storage[1024][512],write_stage,crc_hi;
static unsigned head,tail,services,commands,writes,ignored_resets,reset_attempts,acmd_waits,response_delay,high_clocks;
static uint8_t card_256mb;
static int cmd8_reply=-1;
static unsigned transient_cmd8_zero;
static uint8_t bad_app_cmd,force_ocr_ccs,force_csd_v2;
static unsigned ocr_busy_polls,ocr_reads;
static uint8_t override_ocr;
static uint32_t custom_ocr;
static uint32_t tick,write_sector;
uint32_t HAL_GetTick(void) { return tick; }
void HAL_Delay(uint32_t n) { tick+=n; }
void SD_SPI_Service(void) { services++; assert(!tft_selected); }
static void push(uint8_t b) { assert(head<sizeof(replies)); replies[head++]=b; }
static uint16_t checksum(const uint8_t *bytes,unsigned len)
{
    uint16_t c=0;
    for (unsigned i=0;i<len;++i) {
        c^=(uint16_t)bytes[i]<<8;
        for (unsigned j=0;j<8;++j) c=(c&0x8000U) ? (uint16_t)((c<<1)^0x1021U) : (uint16_t)(c<<1);
    }
    return c;
}
static void block(const uint8_t *bytes,unsigned len)
{
    push(0xFF); push(0xFE);
    for (unsigned i=0;i<len;++i) push(bytes[i]);
    uint16_t c=checksum(bytes,len); push(c>>8); push((uint8_t)c ^ bad_crc);
}
void HAL_GPIO_WritePin(GPIO_TypeDef *port,uint16_t pin,GPIO_PinState state)
{
    if (port==TFT_CS_GPIO_Port && pin==TFT_CS_Pin) tft_selected=state==GPIO_PIN_RESET;
    if (port==SD_CS_GPIO_Port && pin==SD_CS_Pin) {
        selected=state==GPIO_PIN_RESET;
        if (!selected) { head=tail=0; write_stage=0; command_since_select=0; }
    }
    assert(!(selected && tft_selected));
}
HAL_StatusTypeDef HAL_SPI_Init(SPI_HandleTypeDef *handle)
{
    assert(handle==&spi && !selected && !tft_selected); return HAL_OK;
}
HAL_StatusTypeDef HAL_SPI_Transmit(SPI_HandleTypeDef *handle,const uint8_t *data,uint16_t len,uint32_t timeout)
{
    (void)timeout; assert(handle==&spi && selected && !tft_selected); tick++;
    if (hal_timeout) return HAL_TIMEOUT;
    if (write_stage==2) {
        assert(len==512); memcpy(pending,data,512); write_stage=3; return HAL_OK;
    }
    assert(len==6 && head==tail && !command_since_select);
    command_since_select=1; head=tail=0; commands++;
    uint8_t cmd=data[0]&63U;
    assert(spi.Init.BaudRatePrescaler==
           (cmd==13 || cmd==17 || cmd==24 ? SD_SPI_DATA_PRESCALER : SPI_BAUDRATEPRESCALER_256));
    uint32_t arg=((uint32_t)data[1]<<24)|((uint32_t)data[2]<<16)|((uint32_t)data[3]<<8)|data[4];
    if (absent) return HAL_OK;
    switch(cmd) {
    case 0:
        assert(data[5]==0x95 && high_clocks>=80); ++reset_attempts;
        if (ignored_resets) { --ignored_resets; break; }
        initialized=0; push(1); break;
    case 8: {
        assert(data[5]==0x87);
        uint8_t r=cmd8_reply<0 ? (legacy?5:1) : (uint8_t)cmd8_reply;
        if (transient_cmd8_zero) { --transient_cmd8_zero; r=0; }
        push(r);
        if (r==1) { push(0);push(0);push(1);push(wrong_echo?0xAB:0xAA); }
        break;
    }
    case 55: push(bad_app_cmd?5:(initialized?0:1)); break;
    case 41:
        assert(arg==(legacy?0:0x40000000U));
        if (acmd_waits) { --acmd_waits; push(1); }
        else { initialized=1; push(0); } break;
    case 58: {
        ++ocr_reads;
        uint32_t ocr=override_ocr ? custom_ocr : (legacy && !force_ocr_ccs?0x80FF8000UL:0xC0FF8000UL);
        if (ocr_busy_polls) { --ocr_busy_polls; ocr&=~0x80000000UL; }
        push(0);push(ocr>>24);push(ocr>>16);push(ocr>>8);push(ocr);break;
    }
    case 16: assert(legacy && arg==512);push(0);break;
    case 59: assert(arg==1);push(reject_crc_command?4:0);break;
    case 9: {
        uint8_t csd[16]={0};
        if (legacy) { csd[5]=9;csd[7]=63;csd[8]=0xC0; }
        else csd[0]=0x40;
        if (card_256mb) { assert(legacy); csd[7]=255; csd[9]=3; csd[10]=0x80; }
        if (force_csd_v2) csd[0]=0x40;
        push(0);block(csd,16);break;
    }
    case 17: {
        uint32_t at=legacy?arg/512U:arg; assert(at<1024 && (!legacy || arg%512==0));
        push(0);block(storage[at],512);break;
    }
    case 24:
        write_sector=legacy?arg/512U:arg;
        assert(write_sector<1024 && (!legacy || arg%512==0));
        push(0);write_stage=1;break;
    case 13: push(0);push(0);break;
    default: assert(!"unexpected SD command");
    }
    return HAL_OK;
}
HAL_StatusTypeDef HAL_SPI_TransmitReceive(SPI_HandleTypeDef *handle,const uint8_t *tx,uint8_t *rx,uint16_t len,uint32_t timeout)
{
    (void)timeout; assert(handle==&spi && !tft_selected); tick++;
    if (hal_timeout) return HAL_TIMEOUT;
    for (unsigned i=0;i<len;++i) {
        if (!selected || absent) { rx[i]=0xFF; if (!selected) high_clocks+=8; }
        else if (head!=tail) rx[i]=replies[tail++];
        else if (write_stage==1 && tx[i]==0xFE) { write_stage=2; rx[i]=0xFF; }
        else if (write_stage==3) { crc_hi=tx[i];write_stage=4;rx[i]=0xFF; }
        else if (write_stage==4) {
            assert((((uint16_t)crc_hi<<8)|tx[i])==checksum(pending,512));
            memcpy(storage[write_sector],pending,512); writes++;
            write_stage=0; head=tail=0;
            for (unsigned n=0;n<response_delay;++n) push(0xFF);
            push(bad_write?0x0D:5);push(0);push(0);push(0xFF);rx[i]=0xFF;
        } else if (forever_busy && writes) rx[i]=0;
        else rx[i]=0xFF;
    }
    return HAL_OK;
}
static void init(uint8_t old)
{
    head=tail=initialized=selected=write_stage=absent=bad_crc=bad_write=forever_busy=0;
    legacy=old;services=commands=writes=tick=0;
    reject_crc_command=command_since_select=hal_timeout=wrong_echo=card_256mb=0;
    ignored_resets=reset_attempts=acmd_waits=response_delay=high_clocks=0;
    cmd8_reply=-1; transient_cmd8_zero=0; bad_app_cmd=force_ocr_ccs=force_csd_v2=0;
    ocr_busy_polls=ocr_reads=0; override_ocr=0; custom_ocr=0;
    spi.Init.BaudRatePrescaler=SPI_BAUDRATEPRESCALER_8;
    SD_SPI_Bind(&spi); assert(disk_initialize(0)==0);
    assert(!selected && !tft_selected && spi.Init.BaudRatePrescaler==SPI_BAUDRATEPRESCALER_8);
    assert(sd_spi_diag.error==SD_SPI_OK && sd_spi_diag.crc_enabled);
    LBA_t sectors=0;assert(disk_ioctl(0,GET_SECTOR_COUNT,&sectors)==RES_OK && sectors==1024);
}
int main(void)
{
    for (unsigned old=0;old<2;++old) {
        init(old);
        uint8_t data[1024],out[1024];for (unsigned i=0;i<sizeof(data);++i) data[i]=(uint8_t)(i*13U);
        assert(disk_write(0,data,3,2)==RES_OK && writes==2);
        assert(disk_read(0,out,3,2)==RES_OK && !memcmp(data,out,sizeof(data)));
        assert(disk_ioctl(0,CTRL_SYNC,NULL)==RES_OK && services);
        assert(disk_read(0,out,1024,1)==RES_PARERR);
        bad_crc=1;assert(disk_read(0,out,3,1)==RES_ERROR && disk_status(0)==STA_NOINIT);
        assert(sd_spi_diag.error==SD_SPI_CRC && sd_spi_diag.command==17 && sd_spi_diag.response==0);
        assert(!selected && !tft_selected);
        assert(spi.Init.BaudRatePrescaler==SPI_BAUDRATEPRESCALER_8);
    }
    init(0);bad_write=1;uint8_t data[512]={0};assert(disk_write(0,data,0,1)==RES_ERROR);
    assert(sd_spi_diag.error==SD_SPI_REJECT && sd_spi_diag.token==0x0D);
    init(0);forever_busy=1;assert(disk_write(0,data,0,1)==RES_ERROR && tick<3000 && services);
    assert(sd_spi_diag.error==SD_SPI_BUSY);
    init(0);absent=1;assert(disk_initialize(0)==STA_NOINIT && !selected);
    assert(sd_spi_diag.error==SD_SPI_CMD0 && sd_spi_diag.command==0 && sd_spi_diag.response==0xFF && tick<3000);
    assert(spi.Init.BaudRatePrescaler==SPI_BAUDRATEPRESCALER_8);
    init(1);card_256mb=reject_crc_command=1; ignored_resets=3; acmd_waits=4; reset_attempts=0;
    assert(disk_initialize(0)==0 && reset_attempts==4 && !sd_spi_diag.crc_enabled);
    LBA_t sectors=0; assert(disk_ioctl(0,GET_SECTOR_COUNT,&sectors)==RES_OK && sectors==524288);
    response_delay=5; assert(disk_write(0,data,0,1)==RES_OK);
    uint8_t out[512]; assert(disk_read(0,out,0,1)==RES_OK && !memcmp(data,out,512));
    assert(sd_spi_diag.error==SD_SPI_OK && spi.Init.BaudRatePrescaler==SPI_BAUDRATEPRESCALER_8);
    init(0); wrong_echo=1; assert(disk_initialize(0)==STA_NOINIT && sd_spi_diag.error==SD_SPI_CMD8);
    init(0); hal_timeout=1; assert(disk_read(0,out,0,1)==RES_ERROR);
    assert(sd_spi_diag.error==SD_SPI_HAL && sd_spi_diag.hal_status==HAL_TIMEOUT && !selected);
    assert(!strcmp(SD_SPI_ErrorName(),"HAL") && spi.Init.BaudRatePrescaler==SPI_BAUDRATEPRESCALER_8);

    /* Exact reported failure: a legacy card returns 00 instead of 05 to CMD8.
       Accept it only after independent legacy SD/addressing/CSD validation. */
    for (unsigned reply=0;reply<=4;reply+=4) {
        init(1); card_256mb=1; cmd8_reply=(int)reply; reset_attempts=0;
        assert(disk_initialize(0)==0 && reset_attempts==3);
        assert(sd_spi_diag.cmd8_response==reply && sd_spi_diag.cmd8_retries==2 && sd_spi_diag.legacy_probe);
        assert(disk_ioctl(0,GET_SECTOR_COUNT,&sectors)==RES_OK && sectors==524288);
        assert(disk_write(0,data,3,1)==RES_OK && disk_read(0,out,3,1)==RES_OK && !memcmp(data,out,512));
    }
    init(0); transient_cmd8_zero=1; reset_attempts=0;
    assert(disk_initialize(0)==0 && reset_attempts==2); /* Retry can recover normal SD v2. */
    assert(sd_spi_diag.cmd8_response==1 && sd_spi_diag.cmd8_retries==1 && !sd_spi_diag.legacy_probe);
    assert(disk_write(0,data,3,1)==RES_OK);
    init(1); cmd8_reply=0; bad_app_cmd=1;
    assert(disk_initialize(0)==STA_NOINIT && sd_spi_diag.error==SD_SPI_ACMD41 && !writes);
    init(1); cmd8_reply=0; force_ocr_ccs=1;
    assert(disk_initialize(0)==STA_NOINIT && sd_spi_diag.error==SD_SPI_OCR && !writes);
    init(1); cmd8_reply=0; force_csd_v2=1;
    assert(disk_initialize(0)==STA_NOINIT && sd_spi_diag.error==SD_SPI_CSD && !writes);
    init(1); cmd8_reply=9;
    assert(disk_initialize(0)==STA_NOINIT && sd_spi_diag.error==SD_SPI_CMD8 && !writes);
    init(1); cmd8_reply=0; card_256mb=1; ocr_busy_polls=3; ocr_reads=0;
    assert(disk_initialize(0)==0 && ocr_reads==4 && sd_spi_diag.ocr_valid && sd_spi_diag.ocr==0x80FF8000UL);
    assert(disk_write(0,data,3,1)==RES_OK); /* Delayed OCR ready bit after ACMD41. */
    init(1); override_ocr=1; custom_ocr=0x00FF8000UL; uint32_t start=tick;
    assert(disk_initialize(0)==STA_NOINIT && sd_spi_diag.error==SD_SPI_OCR && !writes);
    assert(sd_spi_diag.ocr_valid && sd_spi_diag.ocr==custom_ocr && tick-start>=1000U && tick-start<2000U);
    init(1); override_ocr=1; custom_ocr=0x80000000UL;
    assert(disk_initialize(0)==STA_NOINIT && sd_spi_diag.error==SD_SPI_OCR && !writes && sd_spi_diag.ocr==custom_ocr);
    init(0); override_ocr=1; custom_ocr=UINT32_MAX;
    assert(disk_initialize(0)==STA_NOINIT && sd_spi_diag.error==SD_SPI_OCR && !writes);
    puts("PASS SD SPI: SDHC/SDSC/256MB, CMD8 recovery, delayed OCR ready/raw diagnostics, addressing guards, CS, speed, CRC and errors");
}
