Paddy625/LapTune_STM32/LapTune/Core/Inc/boot_identity.h

#ifndef LAPTUNE_BOOT_IDENTITY_H
#define LAPTUNE_BOOT_IDENTITY_H
#include <stdint.h>
#define LAPTUNE_FIRMWARE_VERSION "2.2.3"
/* Two reserved 1 KB flash pages, outside the linker's application image. */
uint8_t BootIdentity_Init(void);
const char *BootIdentity_Directory(void);
uint64_t BootIdentity_Counter(void);
/* Consumes this firmware's one-time GPS repair reservation, not a success flag. */
uint8_t BootIdentity_TakeGPSRestore(void);
#ifdef LAPTUNE_HOST_TEST
uint16_t BootFlash_Read(unsigned offset);
uint8_t BootFlash_Program(unsigned offset,uint16_t value);
uint8_t BootFlash_Erase(unsigned page);
#endif
#endif
