Paddy625/LapTune_STM32/(commit log)

2025-11-02 Accelerometer first use
2025-11-03 Configured accelerometer
2026-10-20 Place acceleration extrema to the right of each current reading
2026-10-26 Replace LIS3DH with LSM6DS3 accelerometer and gyroscope
2026-10-26 Display acceleration and gyro min/current/max in paired axis rows
2026-10-26 Log IMU samples with GPS UTC to microSD on shared TFT SPI
2026-10-26 Rotate SD logs every three minutes with continuous sample capture
2026-10-26 Probe legacy SD mode after atypical CMD8 responses with addressing checks
2026-10-26 Log GPS coordinates and RMC ground speed with IMU samples
2026-11-01 Configure GPS at 5 Hz with verified UART setup and log MSL altitude
2026-11-01 Implement P0 logger timing, DRDY DMA acquisition and coherent UBX epochs
2026-11-02 Prevent startup sample loss and add storage, UART and PPS diagnostics
2026-11-04 Add receiver signal and antenna diagnostics for GPS NO FIX
2026-11-04 Keep IMU live without SD and leave GPS acquisition uninterrupted
2026-11-05 Verify GPS UART output mask and expand configuration diagnostics
2026-11-07 Restore 5 Hz GPS with verified PPS timing and independent IMU logging
