Paddy625/LapTune_STM32/(notices)

Notices in the files:
LapTune/Core/Inc/main.h:
Copyright (c) 2025 STMicroelectronics.
All rights reserved.
This software is licensed under terms that can be found in the LICENSE file
